416shihiro/test_Teensy-4.1-Sense/docs/CHAT_SESSION_2026-05-31.md

# チャット経緯（要約）— 2026-05-31

GitHub 上の読み物用。全文 jsonl は **XIAO ワークスペース**の `local-archive/`（gitignore）に保管。

- XIAO 側: `test_XIAO ESP32 S3 Sense/local-archive/chat-2026-05-31-teensy-visualizer/`
- 要約: `SESSION.md`（上記フォルダ）
- トランスクリプト: `transcript-90677230.jsonl`

## このリポジトリが生まれた理由

1. Teensy 4.1 + MPU6050 + ピエゾ + MAX4466 のブレッドボード試作。
2. ブラウザ visualizer（マイク **Mc** / ピエゾ **Pz** つまみ）で `DATA,...` を 115200 表示。
3. XIAO プロジェクトと **別 GitHub リポ**に分割（[`test_XIAO-ESP32-S3-Sense`](https://github.com/416shihiro/test_XIAO-ESP32-S3-Sense)）。

## テストボード写真

[`docs/hardware/BREADBOARD_TEENSY_V0.md`](hardware/BREADBOARD_TEENSY_V0.md) — 元 `IMG_6854`

## 関連リンク

- [`docs/REPOS.md`](../docs/REPOS.md)（XIAO リポ内）— 一覧は XIAO 側 `docs/REPOS.md`
