416shihiro/test_Teensy-4.1-Sense/(commit log)

2026-05-31 Initial Teensy 4.1 Human Instrument prototype with visualizer and breadboard photo.
2026-06-13 Add ICM-20948 firmware, bow calibration, and visualizer for recovery.
2026-06-14 Add MPU6050 firmware, PRY visualizer, and gyro/lin onset detection.
    Reorganize graphs for M4L motion params, share motion_core.js with M4L, and add Bridge serve path for smoother viz during Live sessions.
2026-06-14 Revise chip-frame 3D visualizer with arc meters and linear bars.
    Output raw MPU6050 axes in firmware, sync motion_core to chip frame, and redesign the preview: fixed sensor with bow arrow, Pt/Rl/Yw arcs (omega radius, alpha sweep, smoothing), origin-anchored linear bars, camera/orientation tweaks, and 300% meter labels.
    [chip_frame.h, main.cpp]
2026-06-14 Fix bow-frame linear axes, flip X in firmware, add color grading.
    Gravity subtract uses scaled accel when still; Y/Z bow remap in motion_core. Negate ax/gx in chip_frame.h. Viz adds Color panel knobs and single motion sample per frame.
    [chip_frame.h, main.cpp]
2026-06-17 Update visualizer for G01 5-macro mapping and motion modes
    Visualizer: relabel M4L targets/output groups/HUD/3D meters/legends for FilePos(Roll), Grain(gravity rotation scan), FMfreq(Yaw twist), Volume(piezo), Release(linX), and gyroOnset->NoteOn. Add MOTION_MODES doc and tilt-legacy motion core; sync firmware/scripts.
